hairymnstr/hyperpixel-raspi4b-case/(list of files, cad)

Other CAD files:
scad/main.scad
